emalacrida/Home_environmeter/Documentazione/Immagini/Pcbs.jpg

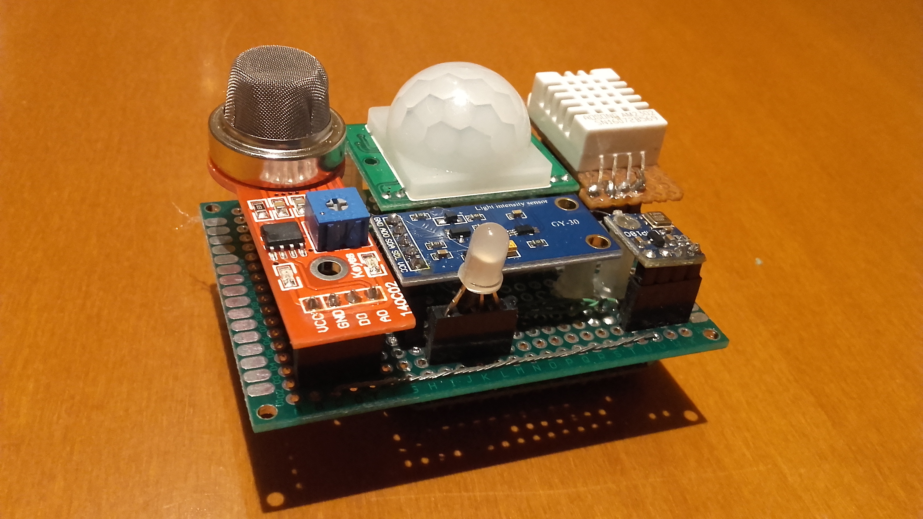
Documentazione/Immagini/Pcbs.jpg
