emalacrida/Home_environmeter/Documentazione/Immagini/Verniciato_1.jpg

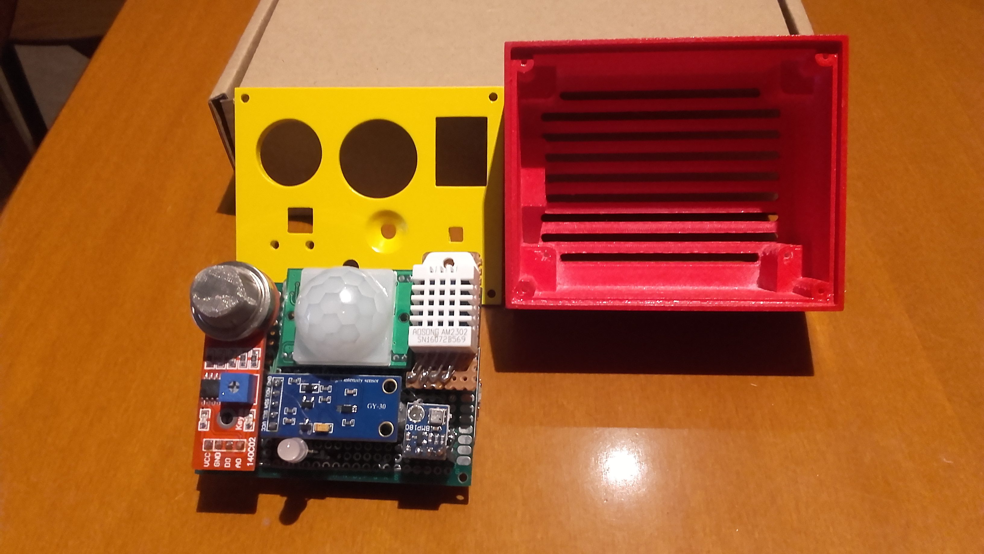
Documentazione/Immagini/Verniciato_1.jpg
