emalacrida/Home_environmeter/Read_me.txt

Tutto cio' che  e' relativo al progetto "x".
