emalacrida/Home_environmeter/Documentazione/Disegni/Read_me.txt

Tutti i documenti realizzativi:
- Files cad parti meccaniche
- Disegni
- Schizzi
- Liste filature/cablaggio
- Files di stampa
