emalacrida/Home_environmeter/Documentazione/Specifiche/Specs_paraetri_ambientali_interni.odt

Sistema che rileva:

Temperatura

Umidità

Pressione

Luminosità ambiente

Qualità aria (veificare misure del sensore)

Presenza persone

I dati sono uplodati su ThingSpeak, sono visibili connettendosi al server web del sensore e consultabili con app sviluppata con Blynk.

Variante per biblioteche:

l'oggetto viene "vestito" da Utente posizionato al banco prestiti, invita gli altri utenti a visitere il sito di ThingSpeak con qrcode e ad andare su paglina web dedicata su cui si descrive meglio le funzionalità. Bisogna pensare alla veste grafica e ad un contenitore (trasparente?) che consenta di vedere come è fatto dentro.

Sensori utilizzati:

Umidità/temperatura: DHT11 oppure DHT22 (sicurament funzione a 3.3V e ha maggiore precisione) fornisce uscita in digitale, esiste libreria per utilizzo.

Pressione/temperatura: BMP-180 (GY-68)

Luminosità ambiente: BY 1750 (GY 30)

Sensore gas: MQ-135 alimentazione 5 V, uscita connessa a A0 con partitore. Rload del sensore 20K partitore (12 e 8 K) (esattamente 20K e 10K)

Sensore di Movimento: PIR HC-SR501
