emalacrida/Home_environmeter/Documentazione/ToDo.odt

Attività per completamento progetto:

OK | Data OK | Data | Descrizione
| | | Inserire parametri di calibrazione misure
| | | Connessione in biblio con captive portal http://stackoverflow.com/questions/33343273/connect-to-captive-portal-wifi-using-esp8266
| | | Misure di taratura temperature
| | | Pagina web
| | | Media su n misure
