emalacrida/Home_environmeter/Codice/Read_me.txt

Tutte le parti di codice necessari per il progetto incluse librerie.
