emalacrida/Home_environmeter/Documentazione/Specifiche/BiblIoT_logo.docx

Studio logo

Bibl-IoT BiblidrIoT

Bibl-IoT BiblidrIoT

Bibl-IoT BiblidrIoT

Bibl-IoT BiblidrIoT

Bibl-IoT BiblidrIoT

Bibl-ioT BibliodrioT

Bibl-IoT BiblidrIoT

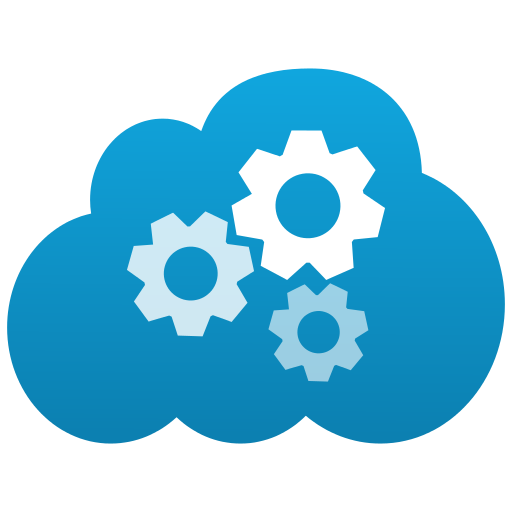
[picture p3: figure]
Risultati immagini per iot
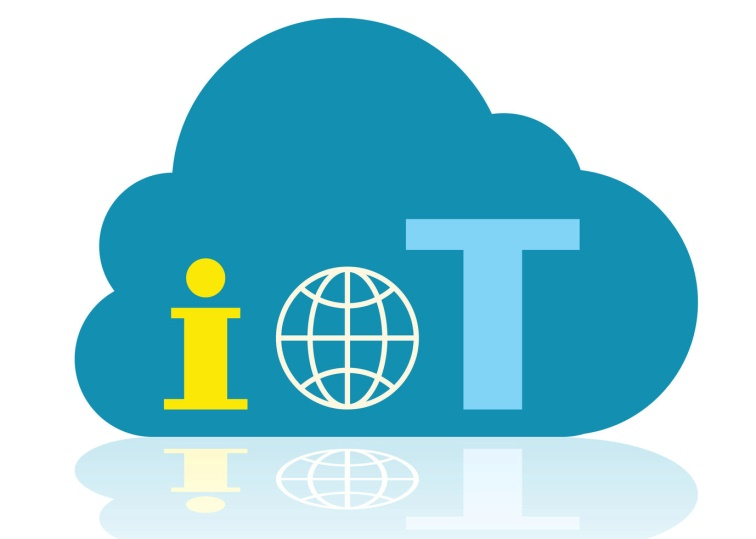
[picture p4: figure]
Risultati immagini per iot
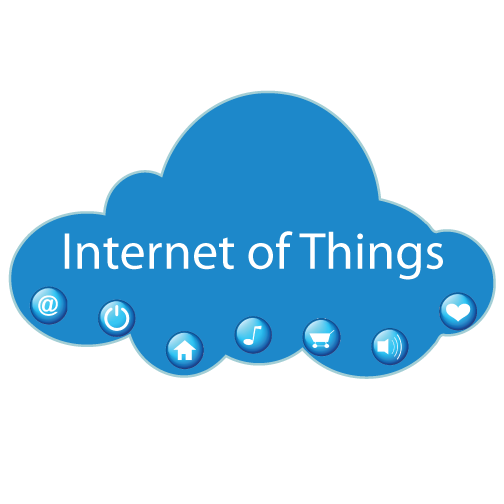
[picture p5: figure]
Risultati immagini per iot
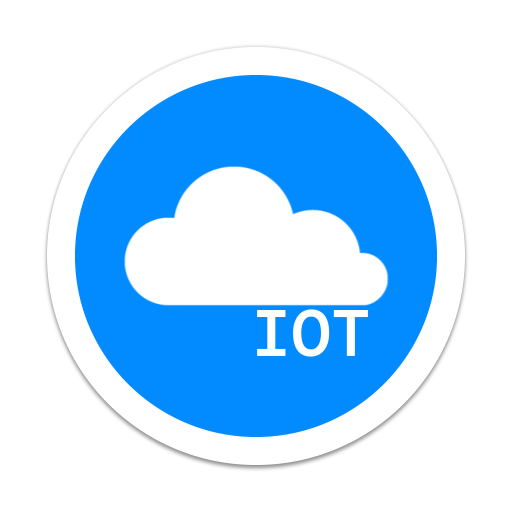
[picture p6: figure]
Risultati immagini per iot
