emalacrida/Home_environmeter/Documentazione/Immagini/20161207_105749.jpg

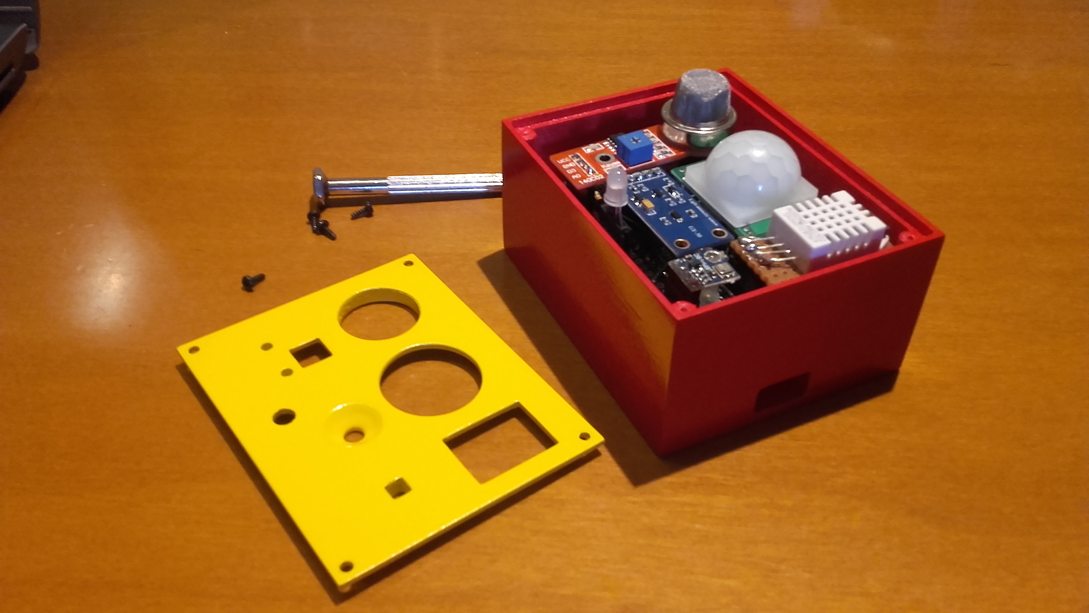
Documentazione/Immagini/20161207_105749.jpg
