emalacrida/Home_environmeter/Documentazione/Immagini/20161207_114357.jpg

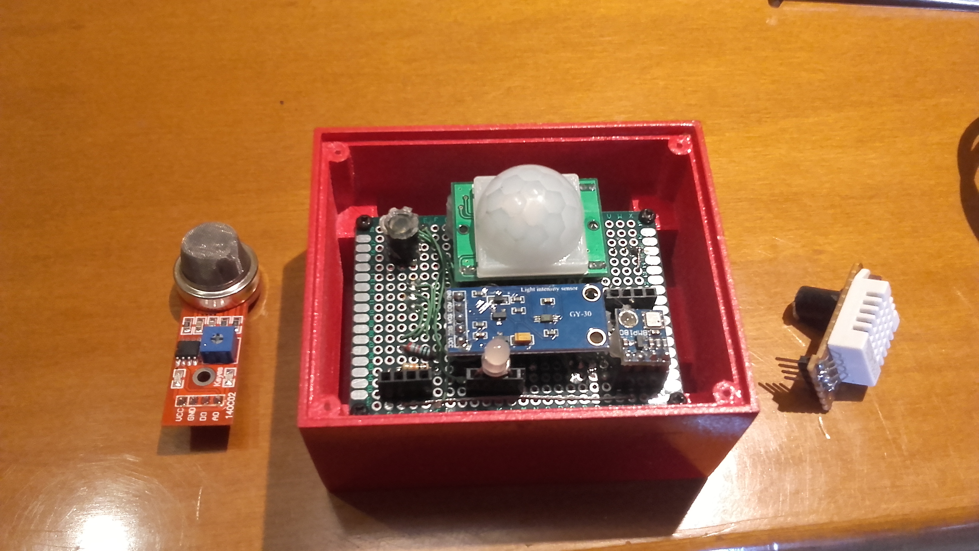
Documentazione/Immagini/20161207_114357.jpg
