emalacrida/Home_environmeter/Documentazione/Immagini/Esp.jpg

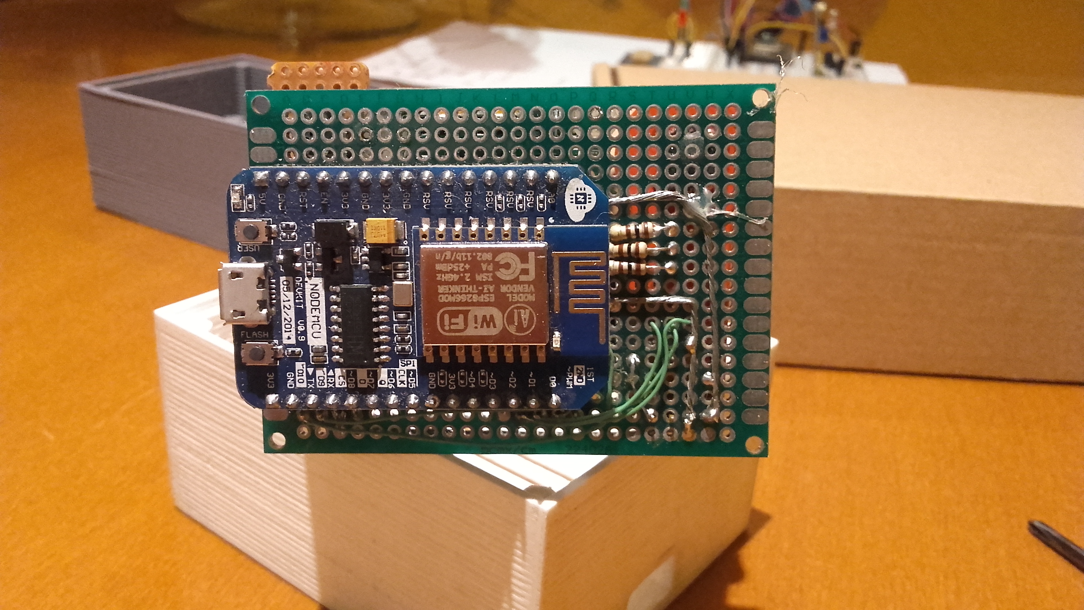
Documentazione/Immagini/Esp.jpg
