emalacrida/Home_environmeter/Documentazione/Immagini/Frontalino_1.jpg

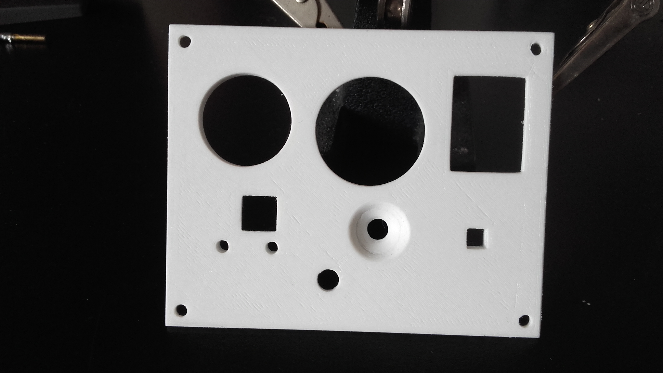
Documentazione/Immagini/Frontalino_1.jpg
