emalacrida/Home_environmeter/Documentazione/Immagini/Frontalino_2.jpg

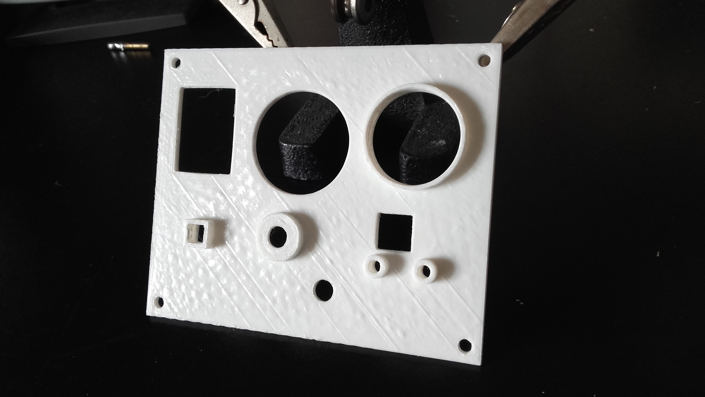
Documentazione/Immagini/Frontalino_2.jpg
