emalacrida/Home_environmeter/Documentazione/Immagini/Scatola_1.jpg

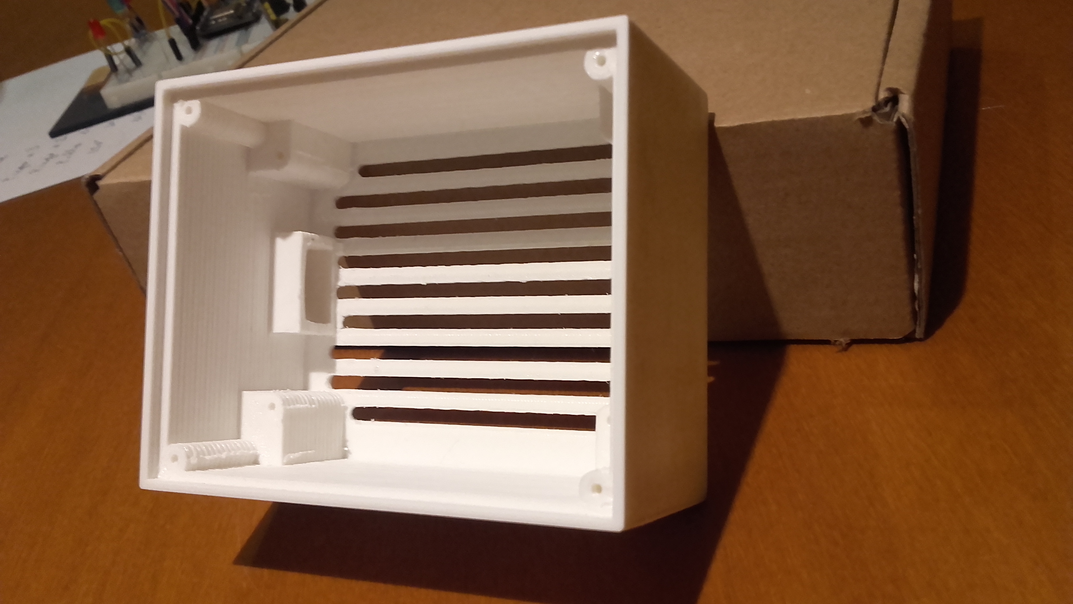
Documentazione/Immagini/Scatola_1.jpg
