emalacrida/Home_environmeter/Documentazione/Immagini/Scatola_2.jpg

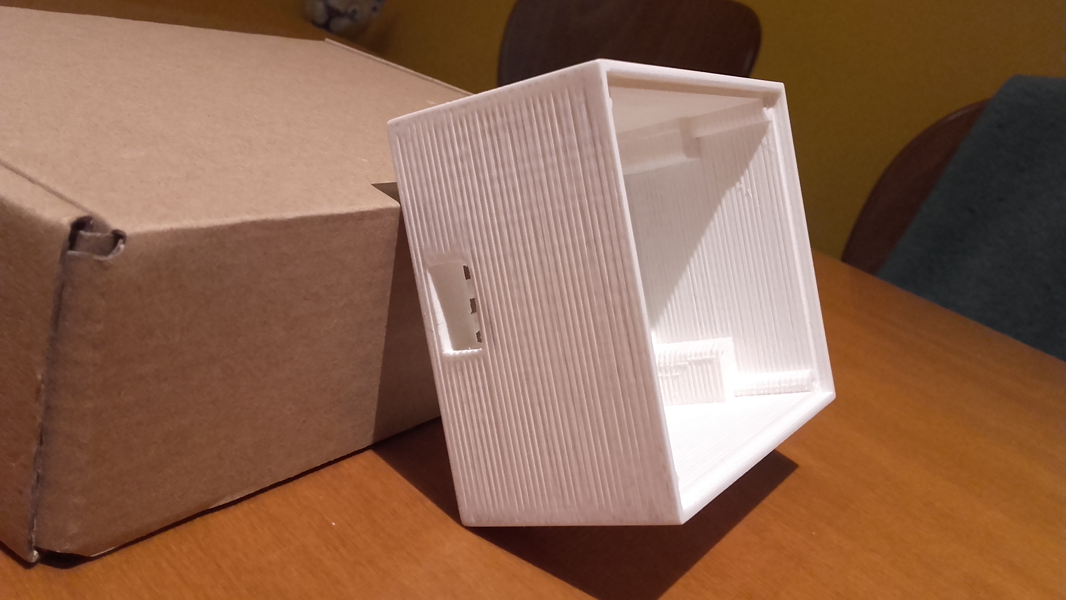
Documentazione/Immagini/Scatola_2.jpg
