emalacrida/Home_environmeter/Documentazione/Immagini/Scatola_3.jpg

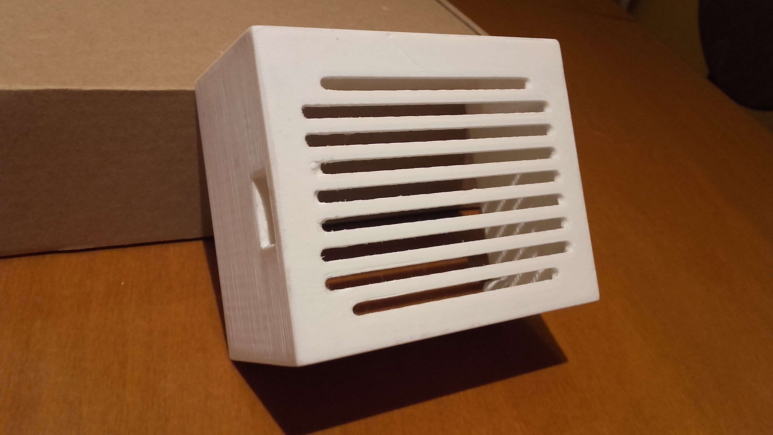
Documentazione/Immagini/Scatola_3.jpg
