emalacrida/Home_environmeter/Documentazione/Immagini/Sensori.jpg

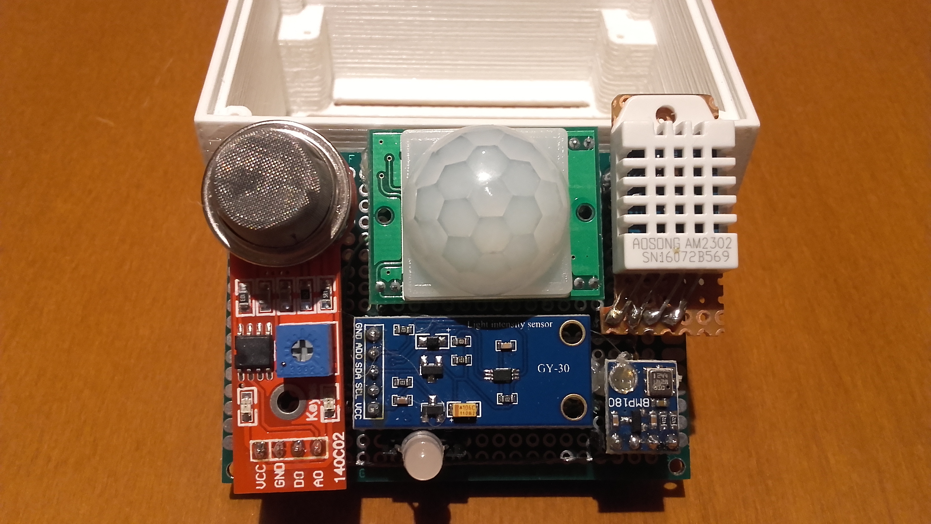
Documentazione/Immagini/Sensori.jpg
