emalacrida/Home_environmeter/Documentazione/Immagini/Verniciato_2.jpg

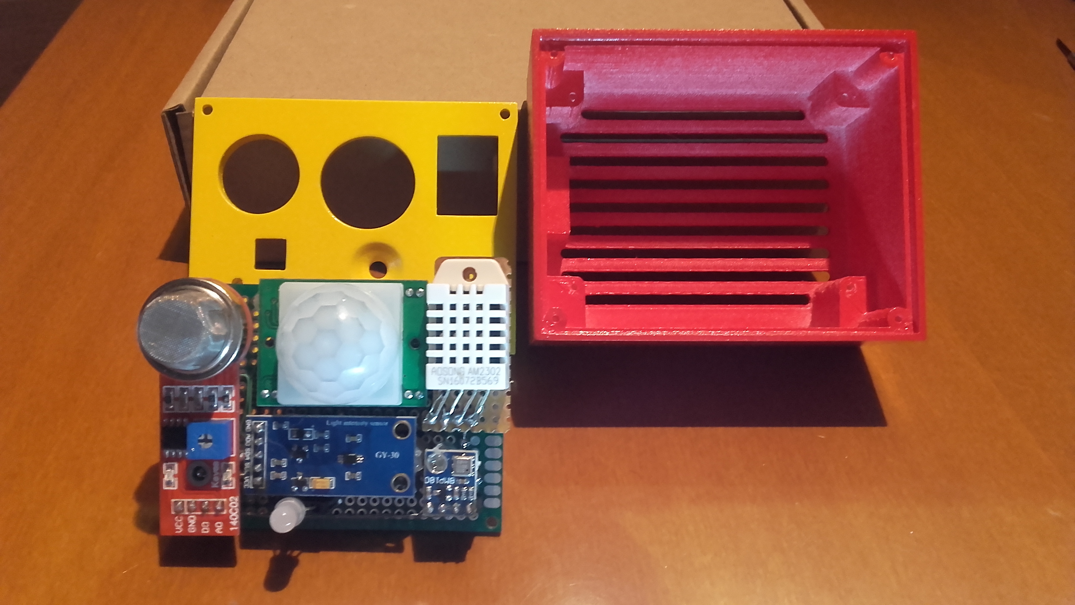
Documentazione/Immagini/Verniciato_2.jpg
