emalacrida/Home_environmeter/Documentazione/Disegni/Sactola_v2_2.stl

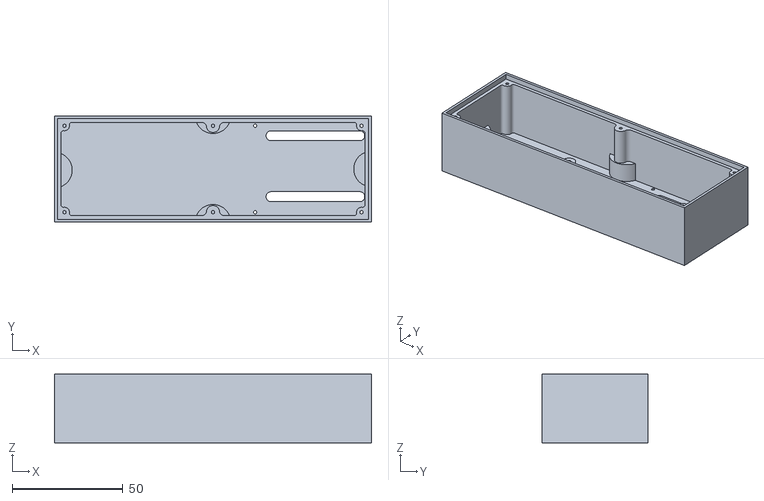
[picture p17: CAD file, 2017-12-16]
Documentazione/Disegni/Sactola_v2_2.stl
143.0 x 48.0 x 31.0
