emalacrida/Home_environmeter/Documentazione/Disegni/Frontalino_6.stl

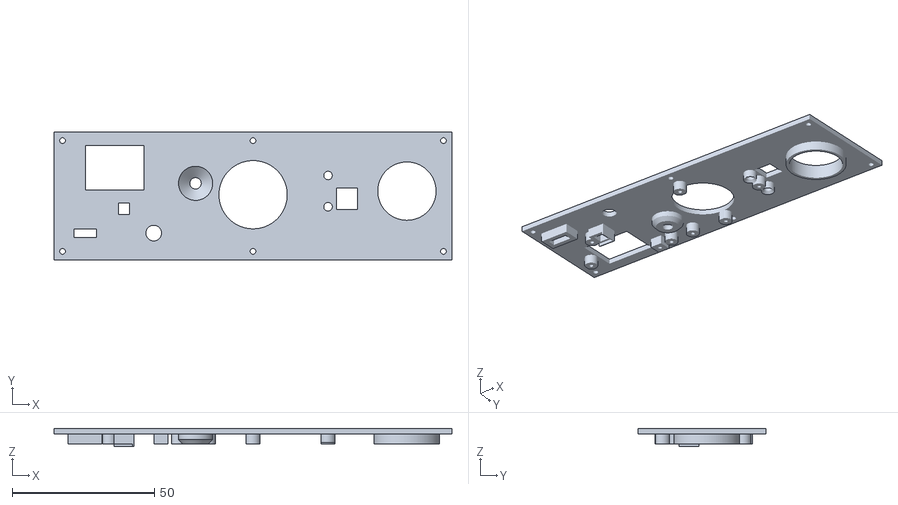
[picture p18: CAD file, 2017-12-16]
Documentazione/Disegni/Frontalino_6.stl
140.0 x 45.0 x 6.50
