emalacrida/Home_environmeter/Documentazione/Disegni/Scatola_V3.stl

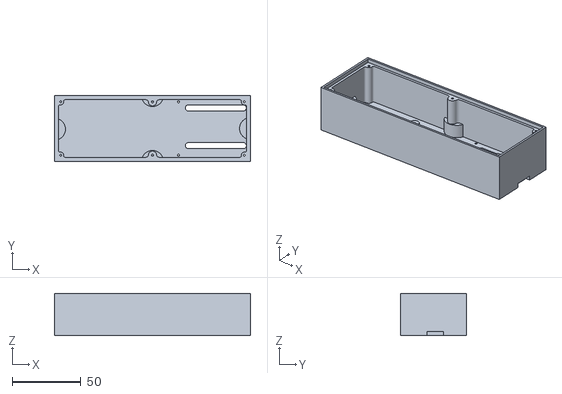
[picture p19: CAD file, 2017-12-16]
Documentazione/Disegni/Scatola_V3.stl
143.0 x 48.0 x 31.0
