emalacrida/Home_environmeter/Documentazione/Disegni/Protezione_esp.stl

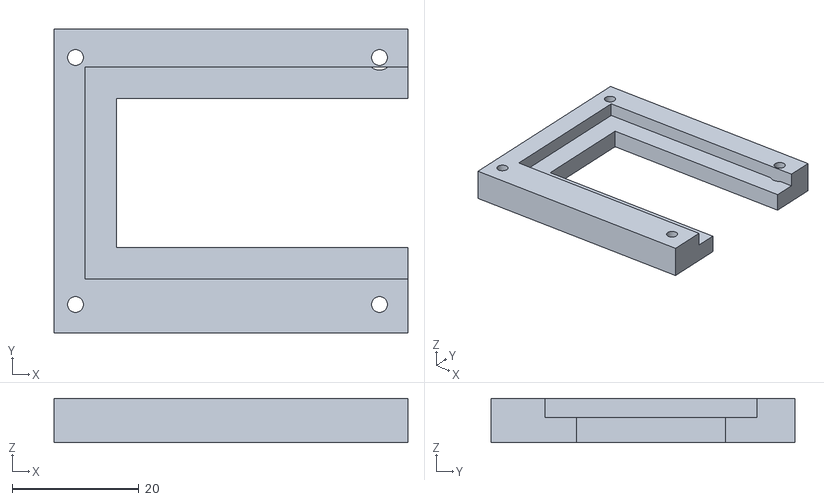
[picture p20: CAD file, 2017-12-16]
Documentazione/Disegni/Protezione_esp.stl
55.9 x 48.0 x 7.00
