emalacrida/Home_environmeter/Documentazione/Disegni/Frontale_v2_5.stl

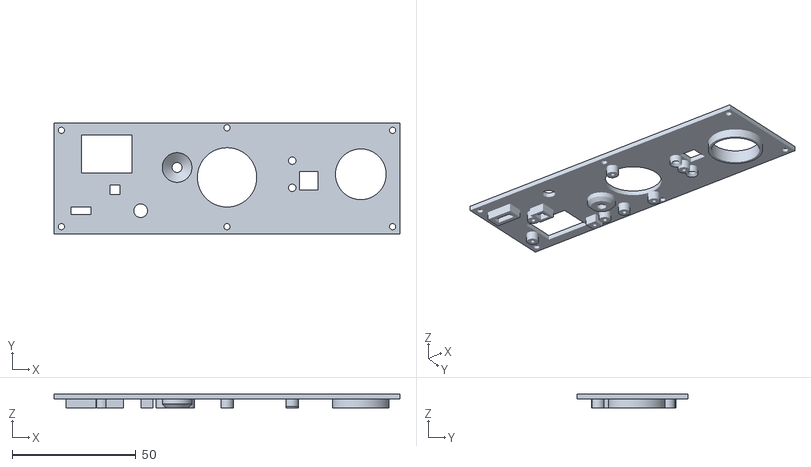
[picture p21: CAD file, 2017-12-16]
Documentazione/Disegni/Frontale_v2_5.stl
140.0 x 45.0 x 5.50
