emalacrida/Home_environmeter/Documentazione/Disegni/Frontale_v2.stl

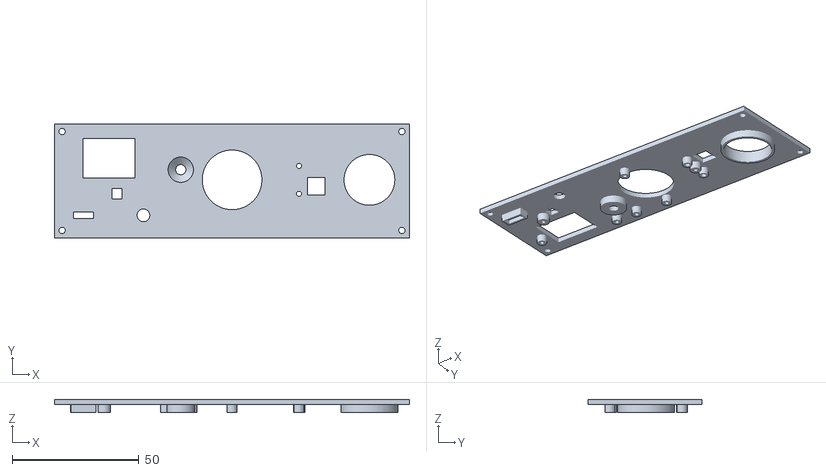
[picture p22: CAD file, 2017-12-16, an earlier design]
Documentazione/Disegni/Frontale_v2.stl
140.0 x 45.0 x 5.00
