emalacrida/Home_environmeter/Documentazione/Manuali/Taratura_temp.ods

Sheet: Sheet1
Rilievi per calcolo costanti di taratura sensori di temperatura
data | ora | Stabile | T DHT | T XXX | T ext_sens | Termocopia | C-A | C-B | B-A
 |  |  | A | B | C | D
18/11/16 | 16.05 | si | 23,90 | 25,50 | 20,10 | 22,00 | -3,80 | -5,40 | -1,60
 | 16.20 | no | 23,40 | 20,43 | 20,40 |  | -3,00 | -0,03 | 2,97 | Spostato in esterno
 | 16.25 | no | 15,80 | 17,07 | 14,70 |  | -1,10 | -2,37 | -1,27
 | 16.55 | no | 12,00 | 12,38 | 8,10 |  | -3,90 | -4,28 | -0,38
 | 17.45 | si | 9,80 | 12,16 | 7,20 |  | -2,60 | -4,96 | -2,36
 | 18.00 | si | 9,60 | 11,78 | 7,20 |  | -2,40 | -4,58 | -2,18
 | 18.12 | si | 10,10 | 12,19 | 7,20 |  | -2,90 | -4,99 | -2,09
 | 19.29 | si | 9,90 | 11,17 | 7,20 |  | -2,70 | -3,97 | -1,27
 | 19.34 | no | 12,50 | 14,63 | 8,60 |  | -3,90 | -6,03 | -2,13 | Spostato vicino acquario
 | 19.36 | no | 14,40 | 16,54 | 11,00 |  | -3,40 | -5,54 | -2,14
 | 20.22 | no | 23,00 | 24,72 | 19,90 |  | -3,10 | -4,82 | -1,72
 | 20.52 | si | 24,30 | 25,81 | 21,30 |  | -3,00 | -4,51 | -1,51
 | 21.43 | si | 24,40 | 26,00 | 21,40 |  | -3,00 | -4,60 | -1,60
19/11/16 | 22.06 | si | 24,60 | 26,10 | 20,90 |  | -3,70 | -5,20 | -1,50
20/11/16 | 10.48 | si | 24,30 | 26,16 | 20,70 |  | -3,60 | -5,46 | -1,86
 | 11.42 | si | 24,70 | 26,26 | 20,90 |  | -3,80 | -5,36 | -1,56
 | 16.57 | no | 23,40 | 22,60 | 20,90 |  | -2,50 | -1,70 | 0,80 | Spostato fuori vicino cucina
 | 17.04 | no | 20,00 | 19,81 | 20,40 |  | 0,40 | 0,59 | 0,19
 | 17.59 | si | 12,80 | 14,62 | 11,60 |  | -1,20 | -3,02 | -1,82
 | 20.32 | si | 12,00 | 14,08 | 8,90 |  | -3,10 | -5,18 | -2,08
 | 22.55 | si | 11,70 | 13,72 | 9,30 |  | -2,40 | -4,42 | -2,02
21/11/16 | 10.18 | si | 12,40 | 14,23 | 9,30 |  | -3,10 | -4,93 | -1,83
 | 11.35 | si | 12,10 | 13,95 | 9,40 |  | -2,70 | -4,55 | -1,85
 | 13.30 | si | 13,00 | 14,70 | 9,90 |  | -3,10 | -4,80 | -1,70
 |  |  |  |  |  |  | 0,00 | 0,00 | 0,00
 |  |  |  |  |  |  | 0,00 | 0,00 | 0,00
 |  |  |  |  |  |  | 0,00 | 0,00 | 0,00
 |  |  |  |  |  |  | 0,00 | 0,00 | 0,00
 |  |  |  |  |  |  | 0,00 | 0,00 | 0,00
 |  |  |  |  |  |  | 0,00 | 0,00 | 0,00
 |  |  |  |  |  |  | 0,00 | 0,00 | 0,00
 |  |  |  |  |  |  | 0,00 | 0,00 | 0,00
 |  |  |  |  |  |  | 0,00 | 0,00 | 0,00

Sheet: Sheet2
 | 18.00.00 | si | 9,6 | 11,78 | 7,2 |  | -2,4 | -4,58 | -2,18
 | 17.45.00 | si | 9,8 | 12,16 | 7,2 |  | -2,6 | -4,96 | -2,36
 | 19.29.00 | si | 9,9 | 11,17 | 7,2 |  | -2,7 | -3,97 | -1,27
 | 18.12.00 | si | 10,1 | 12,19 | 7,2 |  | -2,9 | -4,99 | -2,09
 | 16.55.00 | no | 12 | 12,38 | 8,1 |  | -3,9 | -4,28 | -0,38
 | 19.34.00 | no | 12,5 | 14,63 | 8,6 |  | -3,9 | -6,03 | -2,13
 | 19.36.00 | no | 14,4 | 16,54 | 11 |  | -3,4 | -5,54 | -2,14
 | 16.25.00 | no | 15,8 | 17,07 | 14,7 |  | -1,1 | -2,37 | -1,27
 | 20.02.00 | no | 23 | 24,72 | 19,9 |  | -3,1 | -4,82 | -1,72
 | 16.20.00 | no | 23,4 | 20,43 | 20,4 |  | -3 | -0,03 | 2,97
18/11/16 | 16.05.00 | si | 23,9 | 25,5 | 20,1 | 22 | -3,8 | -5,4 | -1,6
 | 20.52.00 | si | 24,3 | 25,81 | 21,3 |  | -3 | -4,51 | -1,51
 | 21.43.00 | si | 24,4 | 26 | 21,4 |  | -3 | -4,6 | -1,6
