emalacrida/Home_environmeter/Codice/Test_lightsensor/Test_lightsensor.ino

/*
Example of BH1750 library usage.
This example initalises the BH1750 object using the default
high resolution mode and then makes a light level reading every second.
Connection:
 VCC-5v
 GND-GND
 SCL-SCL(analog pin 5) D7
 SDA-SDA(analog pin 4) D6
 ADD-NC or GND
*/

#include <Wire.h>
#include <BH1750.h>


BH1750 lightMeter;


void setup(){
  Serial.begin(115200);
  lightMeter.begin();
  Serial.println("Running...");
}


void loop() {
  uint16_t lux = lightMeter.readLightLevel();
  Serial.print("Light: ");
  Serial.print(lux);
  Serial.println(" lx");
  delay(1000);
}
