emalacrida/Home_environmeter/(commit log)

2016-11-19 nizio monitor progetto
    [Box.stl, Frontalino.stl, Frontalino_1.stl, Frontalino_2.stl, Frontalino_3.stl, Frontalino_4.stl, Frontalino_f.stl, Taratura_temp.ods]
2016-11-19 Alcune cancellazioni di parti commentate Aggiunta dichiarazione di costanti di taratura temperatura
2017-12-16 Versione di produzione iniziale 2.0.
    Il codice caricato in home_environment_2-00.ino
    [Box.stl, Frontale_v2.stl, Frontale_v2_5.stl, Frontalino.stl, Frontalino_1.stl, Frontalino_2.stl, Frontalino_3.stl, Frontalino_4.stl]
